Thbetyfu/Peruri-Chip-Gateway-e-Meterai-dan-Keaslian-Dokumen-Digital/docs/fig/timing_transaksi.png

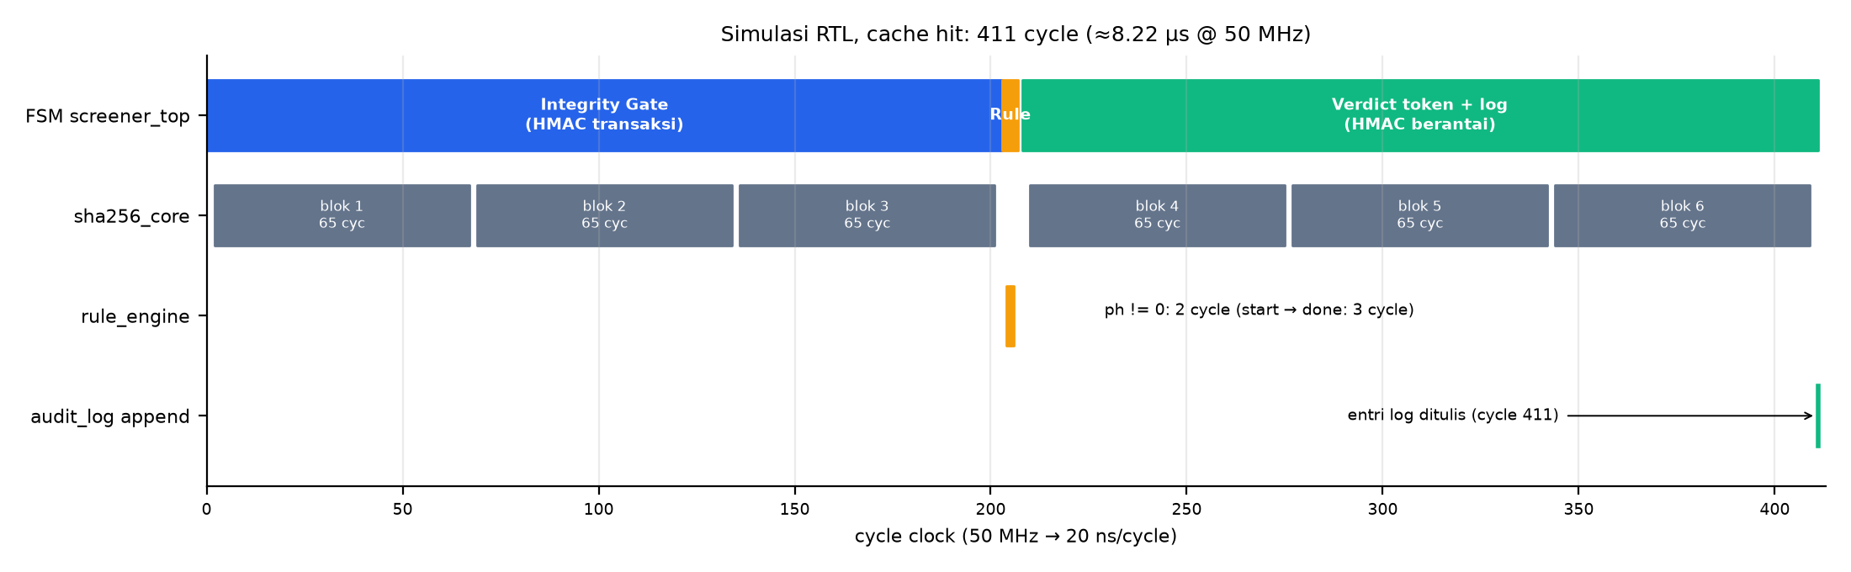
docs/fig/timing_transaksi.png
