Thbetyfu/Peruri-Chip-Gateway-e-Meterai-dan-Keaslian-Dokumen-Digital/docs/fig/wiring_de10nano.png

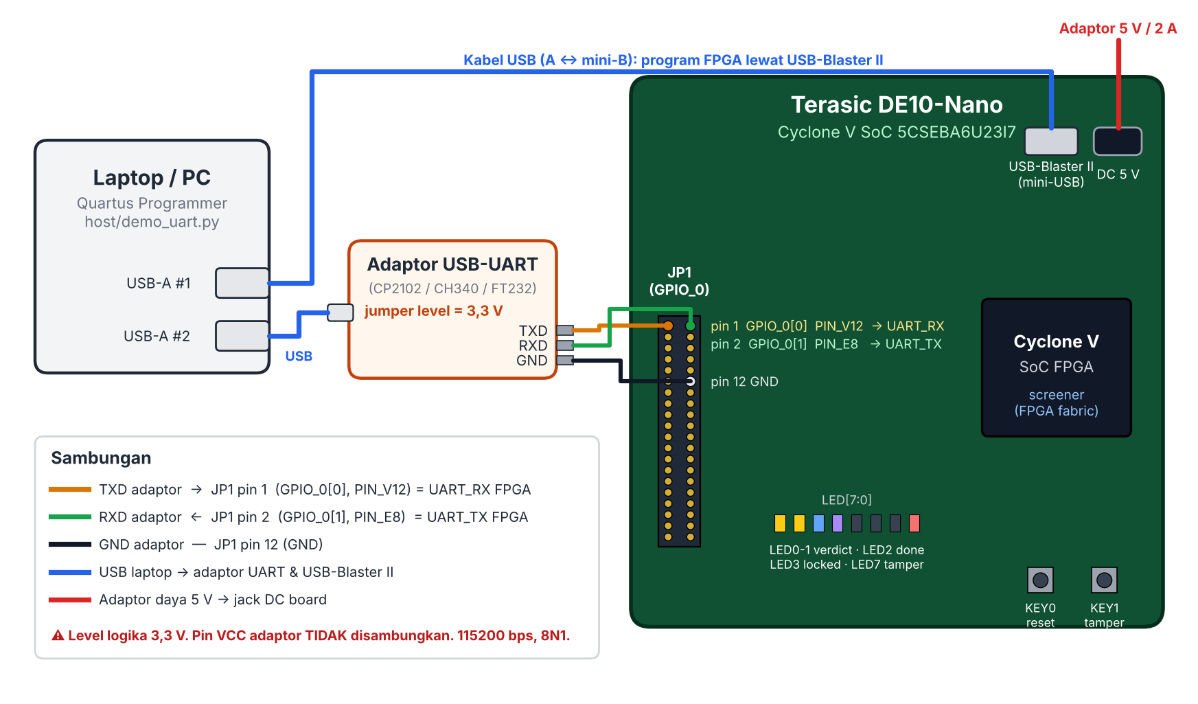
docs/fig/wiring_de10nano.png
