Thbetyfu/Peruri-Chip-Gateway-e-Meterai-dan-Keaslian-Dokumen-Digital/(commit log)

2026-10-06 Integrity-Gated Transaction Screener: RTL, testbench, golden model, proyek Quartus
    [c5_pin_model_dump.txt]
2026-10-06 Tambah ringkasan laporan Quartus (fit & timing) untuk 5CSEBA6U23I7
    ALM 3.535/41.910 (8%), 13 M10K, 0 DSP, Fmax 69,9 MHz worst-case;
    setup & hold terpenuhi pada 50 MHz.
    Claude-Session: https://claude.ai/code/session_01FXL858XHfB8FcUHGvZqPKM
2026-10-06 Hierarki kunci per klien, watermark anti-replay, bukti isolasi kunci
    - key_vault: K_tok = HMAC(K_master, "PERURI-TOKEN-KEY-v1") diturunkan saat LOCK;
    kunci master tidak lagi dipakai langsung untuk transaksi maupun token.
    - screener_top: K_client = HMAC(K_master, "PERURI-CLIENT-KEY-v1" || id) diturunkan
    di chip dengan cache 1 entri (byte 2-3 rekaman = id klien); token memakai K_tok.
    Cache di-zeroize saat tamper.
    - rule_engine: watermark timestamp per slot menutup replay akun yang tergusur.
    - formal/: bukti struktural Yosys bahwa 8 register rahasia & keluaran precompute
    tidak punya jalur ke readdata, dengan kontrol negatif (3 mutan bocor terdeteksi).
    - tb: tes isolasi kunci klien (t11)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
